mmornati/reed-contact-zigbee/docs/it/05-troubleshooting.md

# 5. Risoluzione dei problemi

🌐 [English](../05-troubleshooting.md) · [Français](../fr/05-troubleshooting.md) · **Italiano**

| Sintomo | Causa probabile | Soluzione |
|---|---|---|
| Errore di compilazione *"Select Tools → Zigbee mode…"* | Zigbee mode sbagliata | Tools → Zigbee mode → **Zigbee ZCZR**, Partition → **Zigbee ZCZR 4MB with spiffs** |
| La build fallisce con *ctags: bad CPU type in executable* (Mac Apple Silicon) | Il ctags incluso in Arduino è solo per Intel | Compila con PlatformIO (vedi [Firmware](03-firmware.md)), oppure installa Rosetta: `softwareupdate --install-rosetta --agree-to-license` |
| PlatformIO: *Python version must be 3.10 … 3.14* | Il `platformio` di Homebrew usa un Python più recente | `brew uninstall platformio`, poi `uv tool install --python 3.13 platformio` |
| Errore di compilazione su `requestIASZoneEnroll` / `restoreIASZoneEnroll` | Core ESP32 vecchio | Aggiorna **esp32 by Espressif** alla 3.3.0 o successiva |
| Il LED lampeggia lentamente all'infinito | Non si collega alla rete | Attiva *Permit join* in Z2M; avvicinati a un router; tieni premuto BOOT 3 s per il reset di fabbrica; riflasha con *Erase All Flash = Enabled* |
| Z2M mostra *Unsupported* / *DIY C6ReedContact not supported* | Converter non caricato | Il file deve stare in `external_converters/` con estensione `.mjs`; riavvia Z2M; controlla gli errori nel log |
| ESPHome: *'manufacturer' is an invalid option* o nessun componente `zigbee` | Versione stabile di ESPHome | Installa ESPHome dal ramo `dev` (vedi l'opzione C in [Firmware](03-firmware.md)) |
| Versione ESPHome: Z2M mostra *DIY C6ReedContactESPHome not supported* | Converter sbagliato | Usa `reed_contact_esphome.mjs`; il converter Arduino riconosce solo `C6ReedContact` |
| Versione ESPHome: abbinato, ma `contact` resta vuoto | Binding o prima lettura persi durante l'interview | In Z2M fai *Reconfigure* sul dispositivo, o muovi il magnete una volta; anche l'heartbeat di 5 min lo riempie |
| Abbinato, ma `contact` non cambia mai | Enrollment IAS non completato: Z2M non ha mai scritto il suo indirizzo nel dispositivo | Il log seriale ripete "Enrollment timed out" / "IAS Zone not enrolled": in Z2M apri il dispositivo e clicca *Interview* (*Reconfigure* non serve, risponde "cannot be configured"), oppure rimuovilo, tieni premuto BOOT 3 s e riabbinalo |
| Scheda flashata con cancellazione quando Z2M la conosceva già, e `contact` non cambia più | Rientra con lo stesso indirizzo: Z2M registra solo un rientro e salta l'interview che serve all'enrollment | Quando è rientrata in rete, clicca *Interview* sul dispositivo in Z2M. La prossima volta rimuovi il dispositivo da Z2M prima di flashare con cancellazione, oppure flasha senza cancellare |
| Stato invertito (chiusa risulta aperta) | Reed collegato su **NC** | Sposta il filo su **NO** (vedi la [verifica col multimetro](01-hardware-and-wiring.md#perché-no-e-non-nc)) |
| Lo stato sfarfalla quando il motore gira | Disturbi su un cavo del reed lungo | Aggiungi il pull-up da 10 kΩ + 100 nF; usa cavo intrecciato o schermato; fallo passare lontano dal cavo di rete del motore; aumenta `DEBOUNCE_MS` |
| Funziona al banco, instabile in scatola, o si ferma quando tocchi un filo | Saldatura fredda o filo spezzato | Vedi la [guida alla saldatura](06-soldering.md): prova del filo mosso, rifusione con flussante, fili di campo su morsetti a vite |
| Risulta *chiusa* con la porta aperta di qualche cm | Distanza del magnete troppo tollerante | Sposta reed/magnete in modo che si allineino solo nell'ultimo centimetro, o riduci la distanza |
| Il sensore si scollega quando il tastierino apre la porta | Alimentato dall'uscita **serratura** dello YAVIS | Passa ai morsetti **costanti** `+12V`/`GND` |
| Lo XIAO si resetta o scalda | Uscita del buck sbagliata | Misura: deve essere 5,0–5,1 V; risigilla il trimmer |
| LQI scarso | Antenna | Controlla che il connettore U.FL sia inserito bene; tieni l'antenna lontana dal buck e dal metallo; verifica che `useExternalAntenna()` venga eseguita |
| Cover sempre *unavailable* in HA | Entity ID diversi | Correggi gli ID in `garage_door.yaml`; i friendly name in Z2M devono essere `garage_door_sensor` e `garage_opener` |

## Righe utili del log seriale

```
Starting Zigbee (router)
Joining network.....
Requesting IAS Zone enrollment     (first pairing)
Restoring IAS Zone enrollment      (after a reboot)
Enrolled
Contact CLOSED / Contact OPEN
```

Aprire la porta seriale riavvia lo XIAO, quindi a ogni avvio del monitor rivedi il log di boot.
