mmornati/reed-contact-zigbee/site/i18n.js

// Website translations. English lives in index.html itself; each key here must match a
// data-i18n / data-i18n-attr key in the page (checked in CI by site/test/i18n.test.mjs).

export const SUPPORTED = ['en', 'fr', 'it'];

export const translations = {
  fr: {
    'meta.description': "Un capteur d'ouverture Zigbee alimenté sur secteur qui renforce aussi votre maillage. Seeed XIAO ESP32-C6 + un interrupteur reed, prêt pour Zigbee2MQTT et Home Assistant. Flashez-le depuis votre navigateur.",

    'nav.why': 'Pourquoi',
    'nav.uses': 'Usages',
    'nav.flash': 'Flasher',
    'nav.garage': 'Exemple garage',
    'nav.faq': 'FAQ',
    'nav.language': 'Langue',

    'hero.eyebrow': 'Open source · Zigbee 3.0 · Sans cloud',
    'hero.title': 'Soyez sûr que c\'est <span class="grad">fermé.</span>',
    'hero.lede': 'Un <strong>capteur d\'ouverture Zigbee</strong> alimenté sur secteur qui <strong>renforce aussi votre maillage</strong>. Un Seeed XIAO ESP32-C6 et un interrupteur reed à 1 €, prêts pour <strong>Zigbee2MQTT</strong> et <strong>Home Assistant</strong>. Flashez-le depuis votre navigateur en moins d\'une minute.',
    'hero.ctaFlash': 'Flasher depuis le navigateur',
    'hero.ctaGuide': 'Lire le guide de montage',

    'demo.title': 'DÉMO · porte de garage',
    'demo.sceneLabel': "Une porte avec un aimant qui s'éloigne d'un interrupteur reed",
    'demo.hint': 'Touchez la porte pour l\'ouvrir ou la fermer',

    'why.kicker': 'Pourquoi le construire',
    'why.title': 'Un capteur d\'ouverture qui en fait plus.',
    'why.sub': 'Les capteurs sur pile envoient leur état puis se rendorment. Celui-ci reste éveillé, relaie vos autres appareils Zigbee et vous prévient quand quelque chose ne va pas au lieu de tomber en panne en silence.',
    'why.router.title': 'Un routeur Zigbee en prime',
    'why.router.text': 'Alimenté sur secteur, il relaie le trafic de tous les appareils Zigbee voisins. Votre garage, votre abri ou votre portail ont enfin une couverture solide.',
    'why.failsafe.title': 'Sûr par conception',
    'why.failsafe.text': 'Seul un aimant en place donne <em>fermé</em>. Un fil coupé, un connecteur desserré ou un capteur HS apparaissent tous comme <em>ouvert</em>, jamais comme un faux « tout va bien ».',
    'why.native.title': 'Natif Z2M &amp; HA',
    'why.native.text': 'Un contact IAS Zone standard. Un petit convertisseur et il apparaît comme un capteur de porte/fenêtre dans Home Assistant.',
    'why.nocloud.title': 'Sans WiFi, sans cloud',
    'why.nocloud.text': 'Ni mot de passe, ni IP, ni compte d\'application. Il continue de fonctionner quand votre WiFi tombe, et rien ne sort de chez vous.',

    'uses.kicker': 'Partout',
    'uses.title': 'Si un aimant bouge, vous pouvez le surveiller.',
    'uses.sub': 'Le reed va sur la partie fixe, l\'aimant sur la partie mobile. Le même firmware fonctionne pour tous ces cas.',
    'uses.tag': 'GUIDE COMPLET',
    'uses.garage.title': 'Porte de garage',
    'uses.garage.text': 'Détecte « pas <em>complètement</em> fermée », même une porte arrêtée 5 cm trop tôt. S\'associe à un relais Zigbee pour un vrai volet ouvrir/fermer.',
    'uses.gate.title': 'Portail',
    'uses.gate.text': 'Coulissant ou battant. Les longs câbles ne posent pas de problème.',
    'uses.doors.title': 'Portes',
    'uses.doors.text': 'Un reed encastré est invisible une fois posé.',
    'uses.windows.title': 'Fenêtres',
    'uses.windows.text': 'Puits de lumière, oscillo-battantes, fenêtres de toit.',
    'uses.shed.title': 'Abri &amp; cave',
    'uses.shed.text': 'Hors de portée du WiFi, mais dans le maillage.',
    'uses.mailbox.title': 'Boîte aux lettres',
    'uses.mailbox.text': '« Vous avez du courrier » à chaque ouverture.',
    'uses.freezer.title': 'Congélateur &amp; frigo',
    'uses.freezer.text': 'Alertes « ouvert depuis 5 minutes ».',

    'how.kicker': 'Comment ça marche',
    'how.title': 'D\'un aimant à une automatisation.',
    'how.sub': 'Le reed se ferme quand l\'aimant est proche. L\'ESP32-C6 filtre les rebonds, envoie l\'état comme une IAS Zone Zigbee et le renvoie toutes les 5 minutes pour que Home Assistant n\'ait jamais un état périmé.',
    'how.reed.title': 'Reed + aimant',
    'how.reed.text': 'Contact NO vers GND',
    'how.mesh.title': 'Maillage Zigbee',
    'how.ha.text': 'binary_sensor · porte',

    'flash.kicker': 'Flasher',
    'flash.title': 'Pas de toolchain. Juste un câble USB.',
    'flash.sub': 'Branchez le XIAO ESP32-C6 à votre ordinateur et flashez le dernier firmware directement depuis cette page. Vous préférez le compiler vous-même ? Un simple <code>pio run</code> suffit.',
    'flash.card.title': 'Installer le firmware',
    'flash.card.text': 'Fonctionne avec Chrome et Edge sur ordinateur (Web Serial). Lors de la première installation, choisissez <strong>Erase device</strong> pour que la pile Zigbee démarre proprement.',
    'flash.card.button': 'Connecter &amp; installer',
    'flash.card.unsupported': 'Votre navigateur ne prend pas en charge Web Serial. Ouvrez cette page dans Chrome ou Edge sur un ordinateur.',
    'flash.card.notAllowed': 'Web Serial nécessite une page sécurisée (https).',
    'flash.step1': '<strong>Branchez la carte</strong>En USB-C sur votre ordinateur, sans aucune autre alimentation.',
    'flash.step2': '<strong>Flashez-la</strong>Cliquez sur <em>Connecter &amp; installer</em>, choisissez le port série et acceptez l\'effacement lors de la première installation.',
    'flash.step3': '<strong>Ajoutez le convertisseur</strong>Déposez <code>reed_contact.mjs</code> dans le dossier <code>external_converters/</code> de Zigbee2MQTT et redémarrez-le.',
    'flash.step4': '<strong>Appairez</strong>Cliquez sur <em>Permit join</em>. La LED clignote pendant la recherche et s\'éteint une fois connectée. Maintenez BOOT 3 s pour réinitialiser.',

    'converter.title': 'Douze lignes et c\'est appairé.',
    'converter.sub': 'Le convertisseur utilise les briques de Zigbee2MQTT, et la CI le teste avec la même bibliothèque que Z2M. Le nom du modèle est vérifié par rapport au code du firmware à chaque commit.',

    'garage.kicker': 'Exemple complet',
    'garage.title': 'La porte de garage qui vous dit qu\'elle n\'est pas fermée.',
    'garage.sub': 'Le guide complet associe le capteur à un relais Zigbee ZB-SW01 branché sur l\'entrée bouton-poussoir du moteur. Un package Home Assistant prêt à l\'emploi transforme les deux en un vrai <code>cover</code>.',
    'garage.verify.title': 'Fermer &amp; vérifier',
    'garage.verify.text': 'Demande au moteur de fermer, puis vérifie que la porte est bien fermée en moins de 90 s.',
    'garage.open.title': 'Alerte porte ouverte',
    'garage.open.text': 'Vous prévient au bout de N minutes. Vous choisissez N depuis le tableau de bord.',
    'garage.night.title': 'Contrôle du soir',
    'garage.night.text': 'Un rappel à 22:00 si la porte n\'est pas fermée.',
    'garage.offline.title': 'Capteur hors ligne',
    'garage.offline.text': 'Sachez quand le capteur lui-même ne répond plus.',
    'garage.notif.now': 'maintenant',
    'garage.notif.title': 'Porte de garage',
    'garage.notif1': 'Fermeture demandée, mais la porte n\'est toujours pas complètement fermée après 90 s.',
    'garage.notif2': 'Il est 22:00 et la porte de garage n\'est pas complètement fermée.',

    'bom.kicker': 'Liste des composants',
    'bom.title': 'Environ 15 € de composants.',
    'bom.sub': 'Plus l\'alimentation 12 V que vous avez sans doute déjà près d\'un moteur ou d\'un kit de contrôle d\'accès.',
    'bom.part': 'Composant',
    'bom.why': 'Pourquoi',
    'bom.price': 'Prix approx.',
    'bom.xiao': 'Radio Zigbee + MCU, connecteur d\'antenne U.FL',
    'bom.antenna.name': 'Antenne U.FL 2,4 GHz',
    'bom.antenna': 'De la portée même dans un boîtier',
    'bom.reed.name': 'Interrupteur reed (NO/NC) + aimant',
    'bom.reed': 'Le capteur lui-même',
    'bom.buck.name': 'Convertisseur abaisseur LM2596',
    'bom.box.name': 'Boîtier IP65/67 + presse-étoupes',
    'bom.box': 'Prêt pour garage, portail ou jardin',
    'bom.rc': 'Signal propre sur les longs câbles',
    'bom.cents': 'centimes',

    'faq.title': 'Bonnes questions.',
    'faq.zigbee.q': 'Pourquoi Zigbee et pas WiFi / ESPHome ?',
    'faq.zigbee.a': 'Pour un seul contact, Zigbee gagne : il rejoint le maillage que vos autres capteurs utilisent déjà, n\'a besoin d\'aucun identifiant, survit aux coupures WiFi et, alimenté sur secteur, ajoute un routeur là où il en faut souvent un. En échange : mises à jour du firmware en USB plutôt qu\'en WiFi, et un petit convertisseur Z2M. Pour un appareil installé une fois pour toutes, c\'est une bonne affaire.',
    'faq.arduino.q': 'Pourquoi Arduino plutôt qu\'ESP-IDF ?',
    'faq.arduino.a': 'Les deux utilisent la même pile Zigbee d\'Espressif. Avec Arduino, ce capteur tient en ~200 lignes lisibles, plus faciles à reprendre pour tout le monde. ESP-IDF devient intéressant pour des clusters personnalisés, une optimisation de batterie au µA près ou un produit commercial.',
    'faq.battery.q': 'Peut-il fonctionner sur batterie ?',
    'faq.battery.a': 'Oui, mais il devrait alors devenir un appareil en veille (sleepy end device) et ne plus router. Les capteurs sur pile du commerce sont moins chers pour ça. Ce projet est fait pour les endroits où l\'alimentation est proche et où un routeur est le bienvenu.',
    'faq.working.q': 'Comment savoir s\'il fonctionne ?',
    'faq.working.a1': 'La LED clignote pendant la recherche d\'un réseau et s\'éteint une fois connectée.',
    'faq.working.a2': 'Zigbee2MQTT l\'affiche comme <strong>Router</strong>, avec <code>contact</code> qui change quand vous bougez l\'aimant.',
    'faq.working.a3': 'L\'état est renvoyé toutes les 5 minutes, et la disponibilité Z2M le signale s\'il disparaît.',
    'faq.tested.q': 'Est-il testé ?',
    'faq.tested.a': 'Chaque commit lance des tests unitaires de la logique anti-rebond et de heartbeat (y compris le débordement de <code>millis()</code>), compile avec PlatformIO et Arduino CLI, teste le convertisseur avec <code>zigbee-herdsman-converters</code> et valide le package Home Assistant avec le vérificateur de configuration de Home Assistant.',

    'docs.kicker': 'Documentation',
    'docs.title': 'Tout, étape par étape.',
    'docs.sub': 'Schémas de câblage, montage testé d\'abord sur l\'établi, flashage, appairage et le package Home Assistant.',
    'docs.d1.title': 'Matériel &amp; câblage',
    'docs.d1.text': 'Alimentation, choix du reed, schéma',
    'docs.d2.title': 'Montage pas à pas',
    'docs.d2.text': 'Du test sur l\'établi à l\'installation',
    'docs.d3.text': 'PlatformIO ou Arduino IDE',
    'docs.d4.text': 'Convertisseur, cover, alertes',
    'docs.d5.title': 'Dépannage',
    'docs.d5.text': 'Symptômes et solutions',
    'docs.releases.title': 'Versions',
    'docs.releases.text': 'Binaires du firmware &amp; sommes de contrôle',

    'final.title': 'Arrêtez de vous demander si c\'est fermé.',
    'final.sub': 'Quinze euros, un après-midi, et un souci de moins.',
    'final.flash': 'Flasher le firmware',
    'final.star': 'Une étoile sur GitHub',

    'footer.license': 'Licence MIT',
    'footer.by': 'par',
    'footer.disclaimer': 'Non affilié à Seeed Studio, Espressif, Zigbee2MQTT ou Home Assistant.',

    'js.open': 'Ouverte',
    'js.closed': 'Fermée',
    'js.copy': 'Copier',
    'js.copied': 'Copié',
  },

  it: {
    'meta.description': 'Un sensore di apertura Zigbee alimentato da rete che rafforza anche la tua mesh. Seeed XIAO ESP32-C6 + un contatto reed, pronto per Zigbee2MQTT e Home Assistant. Flashalo dal browser.',

    'nav.why': 'Perché',
    'nav.uses': 'Utilizzi',
    'nav.flash': 'Flash',
    'nav.garage': 'Esempio garage',
    'nav.faq': 'FAQ',
    'nav.language': 'Lingua',

    'hero.eyebrow': 'Open source · Zigbee 3.0 · Niente cloud',
    'hero.title': 'Sicuro che sia <span class="grad">chiuso.</span>',
    'hero.lede': 'Un <strong>sensore di apertura Zigbee</strong> alimentato da rete che <strong>rafforza anche la tua mesh</strong>. Un Seeed XIAO ESP32-C6 e un contatto reed da 1 €, pronti per <strong>Zigbee2MQTT</strong> e <strong>Home Assistant</strong>. Flashalo dal browser in meno di un minuto.',
    'hero.ctaFlash': 'Flash dal browser',
    'hero.ctaGuide': 'Leggi la guida di montaggio',

    'demo.title': 'DEMO · porta del garage',
    'demo.sceneLabel': 'Una porta con un magnete che si allontana da un contatto reed',
    'demo.hint': 'Tocca la porta per aprirla o chiuderla',

    'why.kicker': 'Perché costruirlo',
    'why.title': 'Un sensore di apertura che fa la sua parte.',
    'why.sub': 'I sensori a batteria inviano lo stato e tornano a dormire. Questo resta sveglio, fa da ripetitore per gli altri dispositivi Zigbee e ti avvisa quando qualcosa non va invece di guastarsi in silenzio.',
    'why.router.title': 'Anche un router Zigbee',
    'why.router.text': 'Alimentato da rete, instrada il traffico di tutti i dispositivi Zigbee vicini. Garage, capanno o cancello finalmente hanno una copertura solida.',
    'why.failsafe.title': 'Sicuro per progetto',
    'why.failsafe.text': 'Solo un magnete in posizione dà <em>chiuso</em>. Un filo tagliato, un connettore allentato o un sensore guasto risultano tutti <em>aperto</em>, mai un falso "tutto ok".',
    'why.native.title': 'Nativo per Z2M &amp; HA',
    'why.native.text': 'Un contatto IAS Zone standard. Un piccolo converter e compare come sensore porta/finestra in Home Assistant.',
    'why.nocloud.title': 'Niente WiFi, niente cloud',
    'why.nocloud.text': 'Niente password, IP o account di app. Continua a funzionare quando il WiFi no, e nulla esce da casa tua.',

    'uses.kicker': 'Ovunque',
    'uses.title': 'Se un magnete si muove, puoi controllarlo.',
    'uses.sub': 'Il reed va sulla parte fissa, il magnete su quella mobile. Lo stesso firmware funziona per tutti questi casi.',
    'uses.tag': 'GUIDA COMPLETA',
    'uses.garage.title': 'Porta del garage',
    'uses.garage.text': 'Rileva "non <em>completamente</em> chiusa", anche una porta fermata 5 cm prima. Si abbina a un relè Zigbee per un vero cover apri/chiudi.',
    'uses.gate.title': 'Cancello',
    'uses.gate.text': 'Scorrevole o a battente. I cavi lunghi non sono un problema.',
    'uses.doors.title': 'Porte',
    'uses.doors.text': 'Un reed a incasso è invisibile una volta montato.',
    'uses.windows.title': 'Finestre',
    'uses.windows.text': 'Lucernari, anta-ribalta, finestre da tetto.',
    'uses.shed.title': 'Capanno &amp; cantina',
    'uses.shed.text': 'Fuori portata del WiFi, dentro la mesh.',
    'uses.mailbox.title': 'Cassetta postale',
    'uses.mailbox.text': '"È arrivata la posta" a ogni apertura.',
    'uses.freezer.title': 'Freezer &amp; frigo',
    'uses.freezer.text': 'Avvisi "aperto da 5 minuti".',

    'how.kicker': 'Come funziona',
    'how.title': 'Da un magnete a un\'automazione.',
    'how.sub': 'Il reed si chiude quando il magnete è vicino. L\'ESP32-C6 applica il debounce, invia lo stato come IAS Zone Zigbee e lo ripete ogni 5 minuti, così Home Assistant non ha mai uno stato vecchio.',
    'how.reed.title': 'Reed + magnete',
    'how.reed.text': 'Contatto NO verso GND',
    'how.mesh.title': 'Mesh Zigbee',
    'how.ha.text': 'binary_sensor · porta',

    'flash.kicker': 'Flash',
    'flash.title': 'Nessuna toolchain. Solo un cavo USB.',
    'flash.sub': 'Collega lo XIAO ESP32-C6 al computer e flasha l\'ultimo firmware direttamente da questa pagina. Preferisci compilarlo tu? Basta un <code>pio run</code>.',
    'flash.card.title': 'Installa il firmware',
    'flash.card.text': 'Funziona con Chrome ed Edge su computer (Web Serial). Alla prima installazione scegli <strong>Erase device</strong>, così lo stack Zigbee parte pulito.',
    'flash.card.button': 'Collega &amp; installa',
    'flash.card.unsupported': 'Il tuo browser non supporta Web Serial. Apri questa pagina con Chrome o Edge su un computer.',
    'flash.card.notAllowed': 'Web Serial richiede una pagina sicura (https).',
    'flash.step1': '<strong>Collega la scheda</strong>Via USB-C al computer, senza altre alimentazioni.',
    'flash.step2': '<strong>Flashala</strong>Clicca <em>Collega &amp; installa</em>, scegli la porta seriale e accetta la cancellazione alla prima installazione.',
    'flash.step3': '<strong>Aggiungi il converter</strong>Copia <code>reed_contact.mjs</code> nella cartella <code>external_converters/</code> di Zigbee2MQTT e riavvialo.',
    'flash.step4': '<strong>Abbinalo</strong>Clicca <em>Permit join</em>. Il LED lampeggia durante la ricerca e si spegne quando è connesso. Tieni premuto BOOT per 3 s per il reset.',

    'converter.title': 'Dodici righe ed è abbinato.',
    'converter.sub': 'Il converter usa i mattoncini di Zigbee2MQTT, e la CI lo verifica con la stessa libreria che usa Z2M. Il nome del modello viene confrontato con il codice del firmware a ogni commit.',

    'garage.kicker': 'Esempio completo',
    'garage.title': 'La porta del garage che ti dice che non si è chiusa.',
    'garage.sub': 'La guida completa abbina il sensore a un relè Zigbee ZB-SW01 collegato all\'ingresso pulsante del motore. Un package Home Assistant pronto all\'uso li trasforma in un vero <code>cover</code>.',
    'garage.verify.title': 'Chiudi &amp; verifica',
    'garage.verify.text': 'Chiede al motore di chiudere, poi controlla che la porta sia davvero chiusa entro 90 s.',
    'garage.open.title': 'Avviso porta aperta',
    'garage.open.text': 'Ti avvisa dopo N minuti. Scegli N dalla dashboard.',
    'garage.night.title': 'Controllo serale',
    'garage.night.text': 'Un promemoria alle 22:00 se la porta non è chiusa.',
    'garage.offline.title': 'Sensore offline',
    'garage.offline.text': 'Sai quando è il sensore stesso a smettere di rispondere.',
    'garage.notif.now': 'ora',
    'garage.notif.title': 'Porta del garage',
    'garage.notif1': 'È stata richiesta la chiusura, ma dopo 90 s la porta non è ancora completamente chiusa.',
    'garage.notif2': 'Sono le 22:00 e la porta del garage non è completamente chiusa.',

    'bom.kicker': 'Lista dei componenti',
    'bom.title': 'Circa 15 € di componenti.',
    'bom.sub': 'Più l\'alimentatore 12 V che probabilmente hai già vicino a un motore o a un kit di controllo accessi.',
    'bom.part': 'Componente',
    'bom.why': 'A cosa serve',
    'bom.price': 'Prezzo indicativo',
    'bom.xiao': 'Radio Zigbee + MCU, connettore antenna U.FL',
    'bom.antenna.name': 'Antenna U.FL 2,4 GHz',
    'bom.antenna': 'Portata anche dentro una scatola',
    'bom.reed.name': 'Contatto reed (NO/NC) + magnete',
    'bom.reed': 'Il sensore vero e proprio',
    'bom.buck.name': 'Convertitore step-down LM2596',
    'bom.box.name': 'Scatola IP65/67 + pressacavi',
    'bom.box': 'Pronto per garage, cancello o giardino',
    'bom.rc': 'Segnale pulito su cavi lunghi',
    'bom.cents': 'centesimi',

    'faq.title': 'Buone domande.',
    'faq.zigbee.q': 'Perché Zigbee e non WiFi / ESPHome?',
    'faq.zigbee.a': 'Per un singolo contatto Zigbee vince: entra nella mesh che usano già gli altri sensori, non ha bisogno di credenziali, sopravvive ai blackout del WiFi e, essendo alimentato da rete, aggiunge un router proprio dove spesso serve. In cambio: aggiornamenti del firmware via USB invece che via WiFi, e un piccolo converter Z2M. Per un dispositivo che installi una volta sola, è un buon affare.',
    'faq.arduino.q': 'Perché Arduino invece di ESP-IDF?',
    'faq.arduino.a': 'Entrambi usano lo stesso stack Zigbee di Espressif. Con Arduino questo sensore sta in ~200 righe leggibili, più facili da riprendere per chiunque. ESP-IDF conviene per cluster personalizzati, ottimizzazioni della batteria al µA o un prodotto commerciale.',
    'faq.battery.q': 'Può funzionare a batteria?',
    'faq.battery.a': 'Sì, ma dovrebbe diventare un dispositivo dormiente (sleepy end device) e smettere di fare da router. I sensori a batteria commerciali costano meno per questo. Questo progetto è pensato per i posti dove l\'alimentazione è vicina e un router fa comodo.',
    'faq.working.q': 'Come faccio a sapere se funziona?',
    'faq.working.a1': 'Il LED lampeggia mentre cerca una rete e si spegne quando è connesso.',
    'faq.working.a2': 'Zigbee2MQTT lo mostra come <strong>Router</strong>, con <code>contact</code> che cambia quando muovi il magnete.',
    'faq.working.a3': 'Lo stato viene reinviato ogni 5 minuti, e la disponibilità di Z2M lo segnala se sparisce.',
    'faq.tested.q': 'È testato?',
    'faq.tested.a': 'A ogni commit girano i test unitari della logica di debounce e heartbeat (compreso il rollover di <code>millis()</code>), la compilazione con PlatformIO e Arduino CLI, i test del converter con <code>zigbee-herdsman-converters</code> e la validazione del package Home Assistant con il controllo di configurazione di Home Assistant.',

    'docs.kicker': 'Documentazione',
    'docs.title': 'Tutto, passo dopo passo.',
    'docs.sub': 'Schemi di collegamento, montaggio provato prima sul banco, flash, abbinamento e il package Home Assistant.',
    'docs.d1.title': 'Hardware &amp; collegamenti',
    'docs.d1.text': 'Alimentazione, scelta del reed, schema',
    'docs.d2.title': 'Montaggio passo passo',
    'docs.d2.text': 'Dal test sul banco all\'installazione',
    'docs.d3.text': 'PlatformIO o Arduino IDE',
    'docs.d4.text': 'Converter, cover, avvisi',
    'docs.d5.title': 'Risoluzione problemi',
    'docs.d5.text': 'Sintomi e soluzioni',
    'docs.releases.title': 'Release',
    'docs.releases.text': 'Binari del firmware &amp; checksum',

    'final.title': 'Smetti di chiederti se l\'hai chiuso.',
    'final.sub': 'Quindici euro, un pomeriggio e un pensiero in meno.',
    'final.flash': 'Flasha il firmware',
    'final.star': 'Una stella su GitHub',

    'footer.license': 'Licenza MIT',
    'footer.by': 'di',
    'footer.disclaimer': 'Non affiliato a Seeed Studio, Espressif, Zigbee2MQTT o Home Assistant.',

    'js.open': 'Aperta',
    'js.closed': 'Chiusa',
    'js.copy': 'Copia',
    'js.copied': 'Copiato',
  },
};
