mmornati/reed-contact-zigbee/(commit log)

2026-10-28 Reed Contact Zigbee: XIAO ESP32-C6 Zigbee contact sensor
    Firmware (Zigbee router, IAS Zone contact), Zigbee2MQTT converter,
    Home Assistant garage door package, build guides, CI with unit and
    integration tests, release workflow and a GitHub Pages site with a
    browser flasher.
2026-10-28 Add French and Italian: website language selector and translated docs
    - website: EN/FR/IT selector (auto-detects browser language, remembers
    the choice, ?lang= links), translations in site/i18n.js
    - README and the five guides translated to French and Italian, with a
    language bar on every page
    - CI: website translation test (missing/stale keys, markup parity) and
    anchor checking in the docs link check
    [i18n.js]
2026-10-29 Add ESPHome as an alternative firmware
    Same wiring as the Arduino sketch. ESPHome exposes the reed as a Zigbee
    Binary Input (no IAS Zone yet), so it gets its own Z2M converter and the
    model C6ReedContactESPHome, letting both builds coexist in Zigbee2MQTT.
    - esphome/reed-contact.yaml: router, external antenna, 200 ms debounce,
    5 min heartbeat, BOOT factory reset, status LED
    - zigbee2mqtt/reed_contact_esphome.mjs + tests
    - docs (EN/FR/IT): Option C section with comparison, flashing, settings
    mapping, updates (USB or the experimental Zigbee OTA fork), troubleshooting
    Claude-Session: https://claude.ai/code/session_01TAigdCfpo7Sxk8E1yw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
2026-10-29 Add a soldering guide for the XIAO (EN/FR/IT)
    New docs/06-soldering.md: tools and temperatures, pinout of the pads
    used, a perfboard + screw terminal layout so field wires never sit on
    the XIAO pads, step-by-step header soldering, continuity checks before
    power, and a table of common bad joints. Linked from the build guide,
    troubleshooting and the READMEs.
    Claude-Session: https://claude.ai/code/session_01TAigdCfpo7Sxk8E1ywTkte
2026-10-29 Explain three-wire reed switches in the wiring guide
    Alarm reed switches usually have COM, NO and NC wires while the diagram
    shows two. Say so, and add how to spot COM from the multimeter pairs.
    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
2026-10-31 docs: explain capacitor polarity (ceramic vs electrolytic) in wiring and soldering guides
    Claude-Session: https://claude.ai/code/session_01TAigdHRdRACwaDQT2gDGCU
2026-10-31 Troubleshooting: re-interview after an erase-flash, not Reconfigure
    A board erase-flashed while Z2M still knew it rejoins with the same
    address, so Z2M skips the interview and never writes the CIE address.
    IAS enrollment then times out forever. Reconfigure doesn't help (the
    converter has no configure step); Interview does.
